Vassar-Robot-Competition-2018/teamC/notebook/images/week1/IMG_1938.jpg

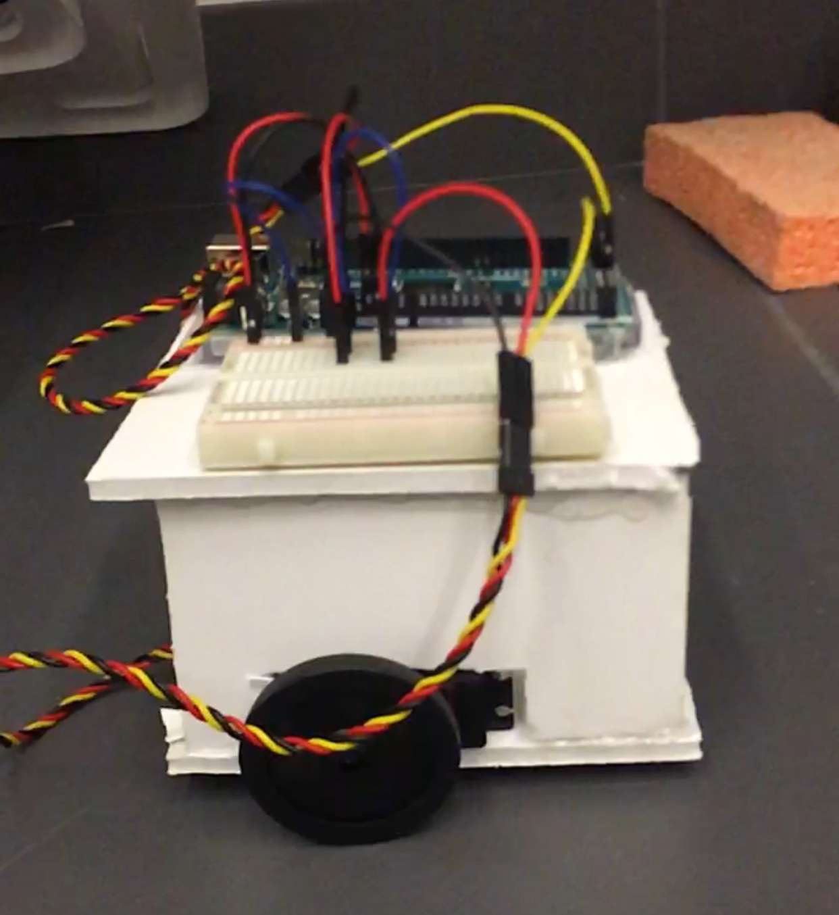
notebook/images/week1/IMG_1938.jpg
