Vassar-Robot-Competition-2018/teamC/notebook/images/week3/Top_view.JPG

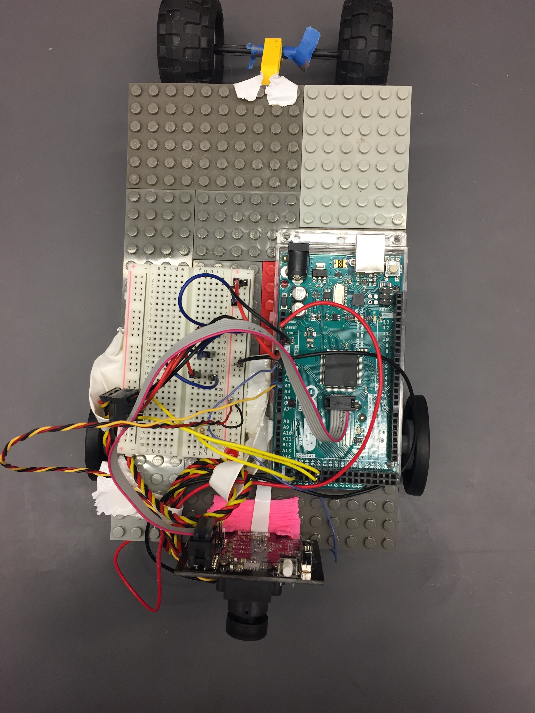
notebook/images/week3/Top_view.JPG
