Vassar-Robot-Competition-2018/teamC/notebook/images/week8/IMG_7218.jpg

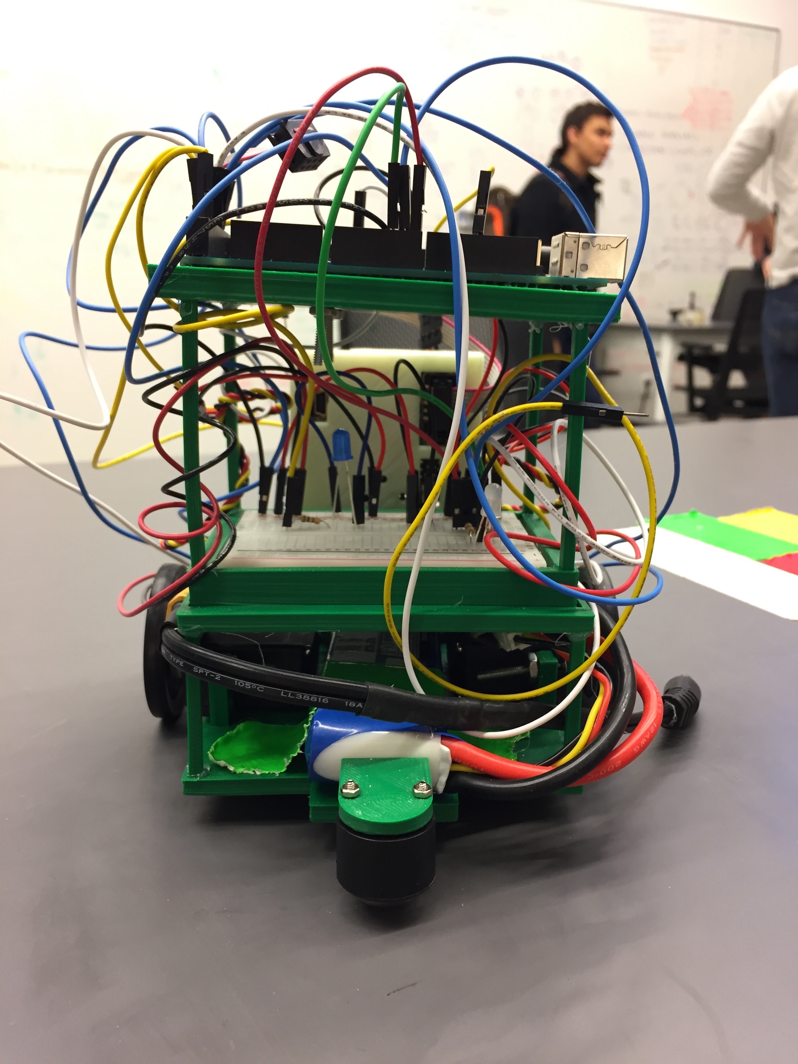
notebook/images/week8/IMG_7218.jpg
