Vassar-Robot-Competition-2018/teamC/notebook/images/week11/IMG_7260.JPG

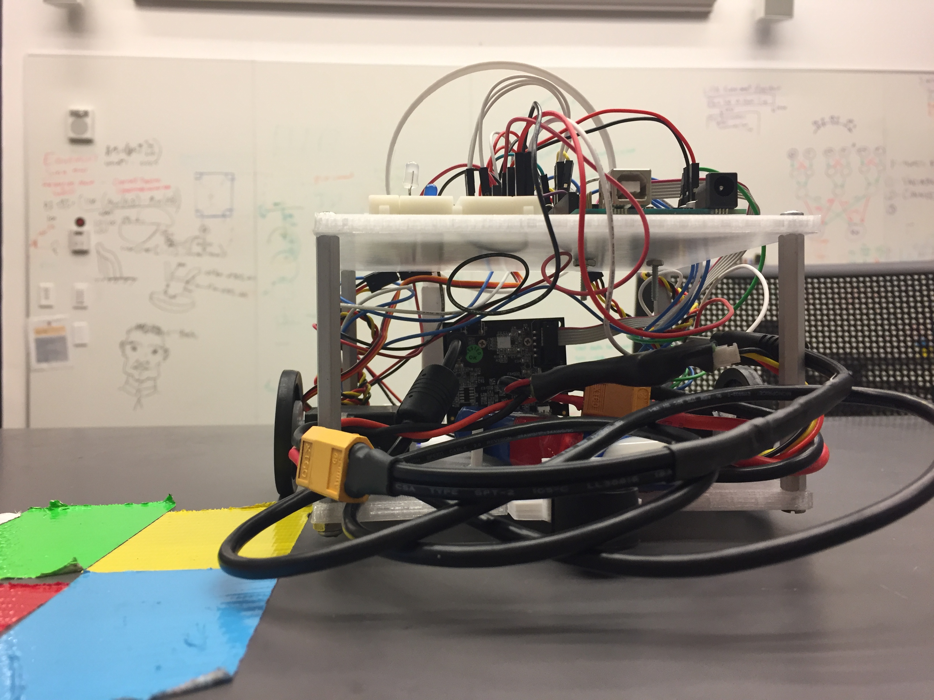
notebook/images/week11/IMG_7260.JPG
