Vassar-Robot-Competition-2018/teamC/(commit log)

2018-02-04 uncommented call for Servo.h library
2018-02-21 week 4 code fix
    included a pixy.init() method call that allows us to use the pixy.getBlocks() method.
    [week_4_code.ino]
